KP1533TM2/m100_expander_proto/hw/main/main.sch

## KiCad design hw/main/main.sch (2020-10-03)

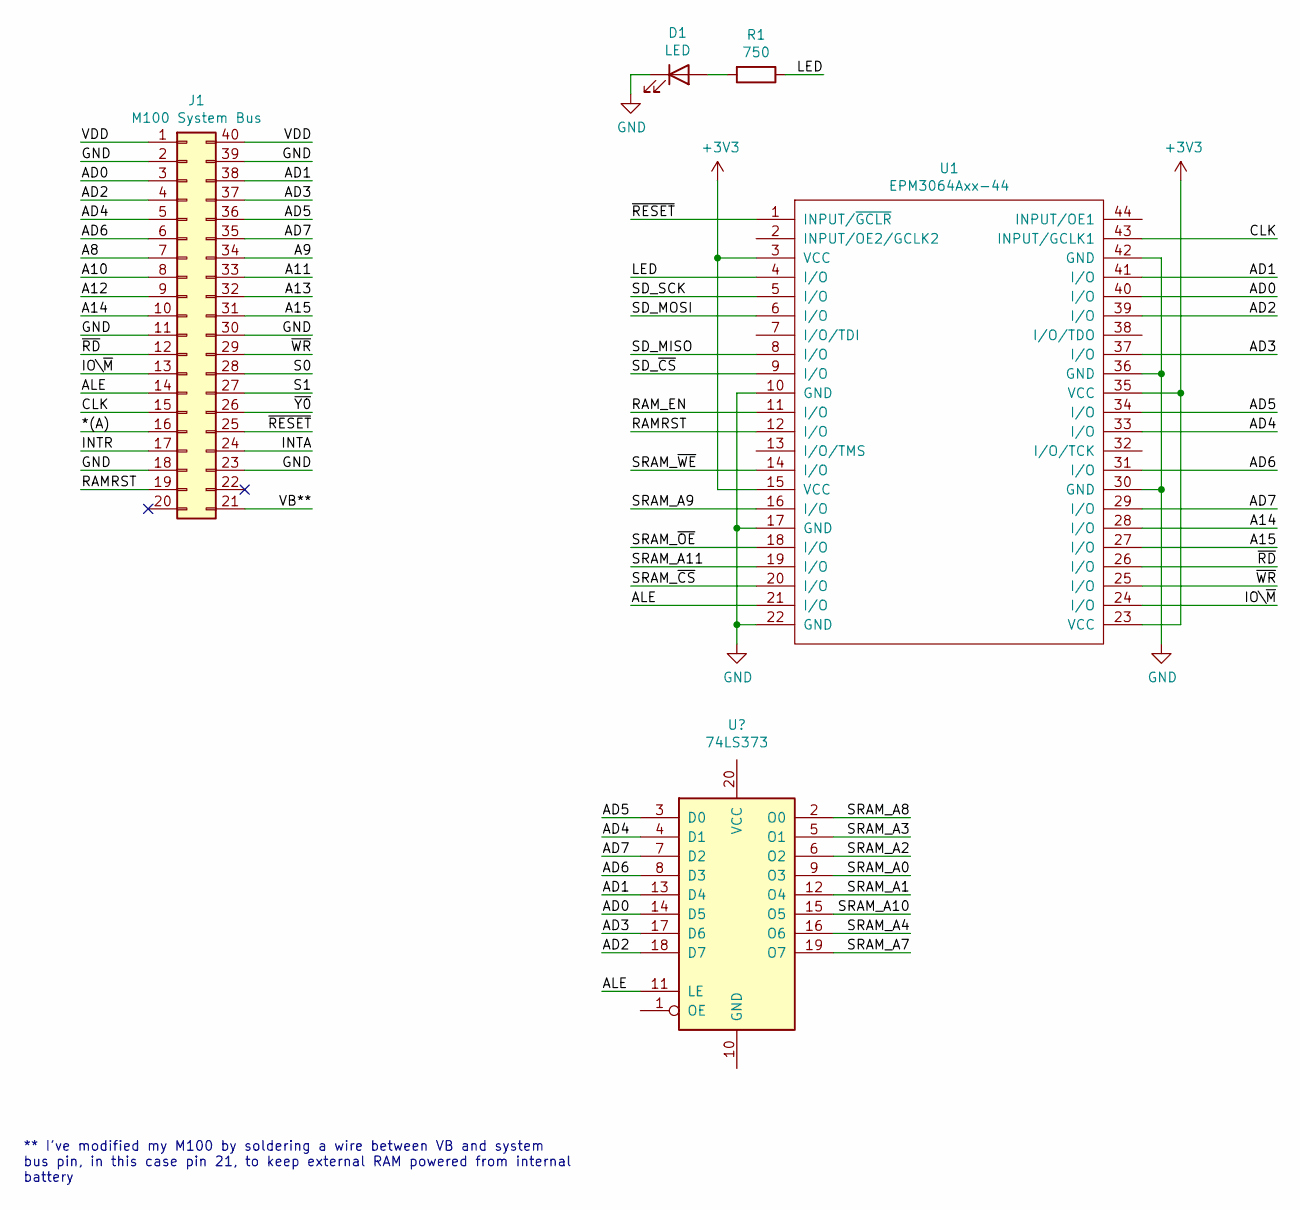
[picture p1: schematic main.sch]

Parts:
D1: LED
J1: M100 System Bus; DIP-40_W15.24mm_Socket
R1: 750
U1: EPM3064Axx-44; TQFP-44_10x10mm_P0.8mm

Connections:
(a): J1.16
+3V3: U1.3 (VCC), U1.15 (VCC), U1.23 (VCC), U1.35 (VCC)
A8: J1.7
A9: J1.34
A10: J1.8
A11: J1.33
A12: J1.9
A13: J1.32
A14: J1.10, U1.28 (I/O)
A15: J1.31, U1.27 (I/O)
AD0: J1.3, U1.40 (I/O)
AD1: J1.38, U1.41 (I/O)
AD2: J1.4, U1.39 (I/O)
AD3: J1.37, U1.37 (I/O)
AD4: J1.5, U1.33 (I/O)
AD5: J1.36, U1.34 (I/O)
AD6: J1.6, U1.31 (I/O)
AD7: J1.35, U1.29 (I/O)
ALE: J1.14, U1.21 (I/O)
CLK: J1.15, U1.43 (INPUT/GCLK1)
GND: D1.1 (K), J1.2, J1.11, J1.18, J1.23, J1.30, J1.39, U1.10 (GND), U1.17 (GND), U1.22 (GND), U1.30 (GND), U1.36 (GND), U1.42 (GND)
INTA: J1.24
INTR: J1.17
IO\~M: J1.13, U1.24 (I/O)
LED: R1.1, U1.4 (I/O)
unnamed: D1.2 (A), R1.2
RAMRST: J1.19, U1.12 (I/O)
RAM_EN: U1.11 (I/O)
S0: J1.28
S1: J1.27
SD_MISO: U1.8 (I/O)
SD_MOSI: U1.6 (I/O)
SD_SCK: U1.5 (I/O)
SD_~CS: U1.9 (I/O)
SRAM_A9: U1.16 (I/O)
SRAM_A11: U1.19 (I/O)
SRAM_~CS: U1.20 (I/O)
SRAM_~OE: U1.18 (I/O)
SRAM_~WE: U1.14 (I/O)
VB**: J1.21
VDD: J1.1, J1.40
~RD: J1.12, U1.26 (I/O)
~RESET: J1.25, U1.1 (INPUT/~GCLR)
~WR: J1.29, U1.25 (I/O)
~Y0: J1.26

Notes on the sheet:
** I've modified my M100 by soldering a wire between VB and system bus pin, in this case pin 21, to keep external RAM powered from internal battery
