KP1533TM2/m100_expander_proto/(commit log)

2020-09-30 32k RAM expansion and SPI port is working
2020-10-01 Option ROM loading works
    * Added small VirtualT IDE project to load Option ROM area from SPI flash ROM
    - Build it, make BASIC loader, transfer it to your M100 somehow,
    over tape or UART; (load"com:98n1e" - 19200 baud)
    - On M100:
    - run
    - clear 256, 58420 (once?)
    - call 58420,<ROM number 0 to 31>
    - press reset (to perhaps let M100 OS see the option ROM)
    - in BASIC, do CALL63012 and enjoy
    - Option ROM images:
    - Should be programmed with a programmer - I didn't make
    any way to download ROMs on M100 yet
    - No option to clear the buffer (to show OS there's no Option ROM
    installed) - I didn't make that either
    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
    [main.vhd, spirom.asm]
2020-10-01 Option ROM loading works
    - call 58240,<ROM number 0 to 31>
    - Laid out starting from flash addr 0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
    [main.vhd, spirom.asm]
2020-10-03 Added KiCad project
    [main.kicad_pcb, main.sch]
2020-10-03 Freed up a pin
    I initially broke out extra signal out of CPLD to control RAM CE2
    (non-inverted), because I needed to deactivate my RAM during power on
    process, before CPU becomes active, for it not to suffer any corruption.
    Signal was initialized to zero, was reset by RESET signal and set by ALE
    going high, thus, when wired to CE2, only enabling RAM after CPU starts
    executing.
    Turns out, I can wire already existing (A)* signal (1 when either /RD
    or /WR is active) to CE2, achieving exactly that with no pins or macrocells.
    This only existed between commits, hence why I'm noting that in the commit
    message, if I ever need to recall what and how I did.
    [main.vhd, spirom.asm]
